Tecnomobele-FGA/Modulo-instrumentacao/figuras/placa_comp_instrumen_montada.jpg

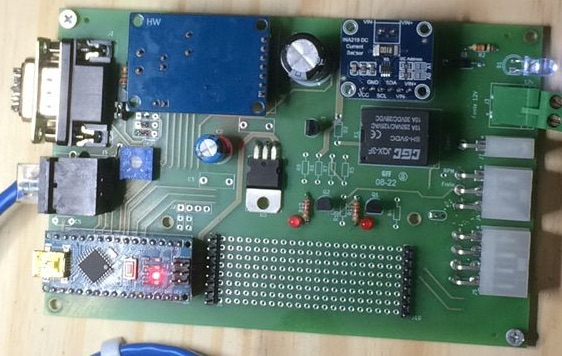
figuras/placa_comp_instrumen_montada.jpg
