Tecnomobele-FGA/Modulo-instrumentacao/figuras/placa_mod_sinal.jpg

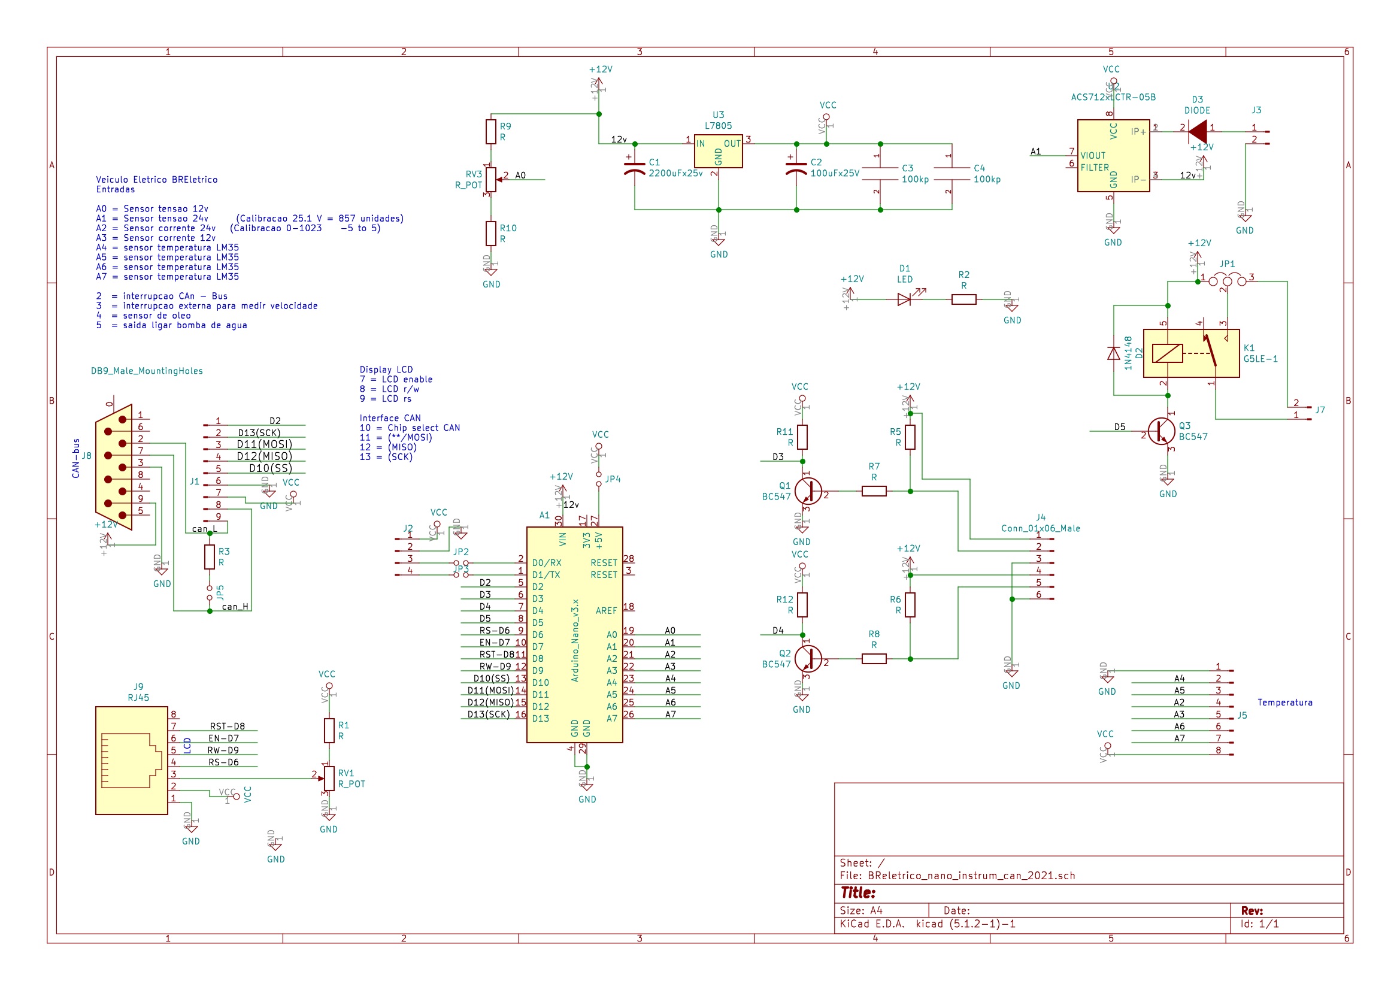
figuras/placa_mod_sinal.jpg
