Tecnomobele-FGA/Modulo-instrumentacao/fotos/foto_placa_instrum.jpg

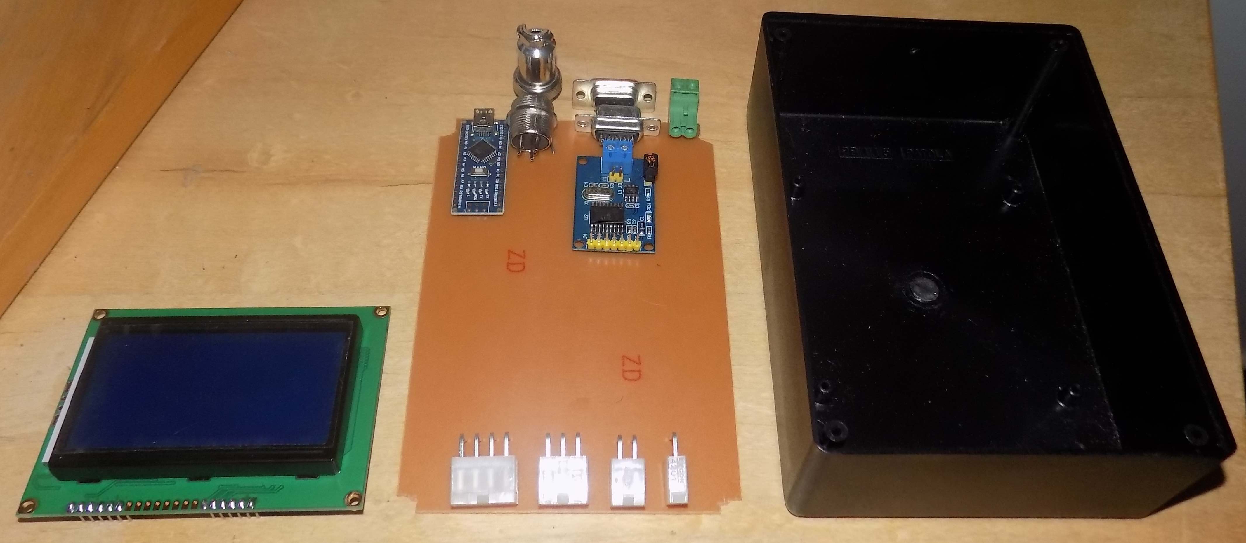
fotos/foto_placa_instrum.jpg
