Tecnomobele-FGA/Modulo-instrumentacao/(commit log)

2020-06-22 foto da placa de instrumentacao
2020-06-22 codigo fonte arduino
2021-03-17 Organizando e incluindo link para o codigo
2021-03-18 Atualizando o PGN e Messagem ID para mandar a velocidade
2021-03-20 calibração sensor de velocidade
2022-03-29 atualizando transdutor 48v
